CrazyGadgetMods/N64-RCP-Flex-Suite/RCP-FFC Cart Side Board/505110-4091/505110-4091.step

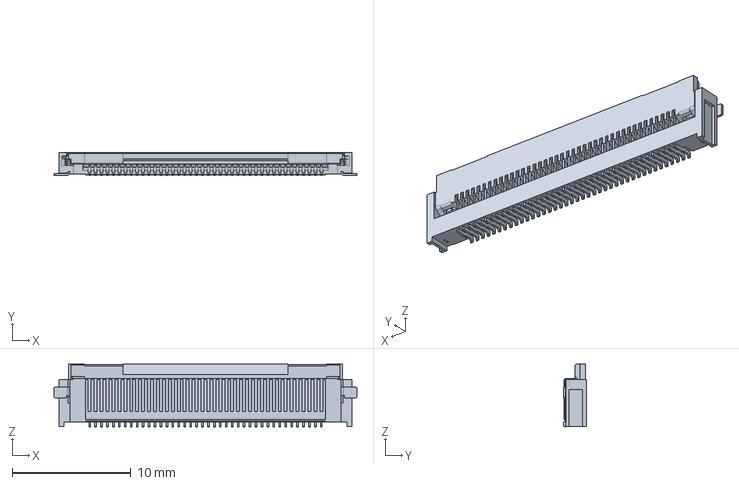
[picture p16: CAD file, 2024-05-08]
RCP-FFC Cart Side Board/505110-4091/505110-4091.step
25.5 x 1.90 x 5.30 mm
