CrazyGadgetMods/N64-RCP-Flex-Suite/RCP Breakout Flex/RCP-FLEX.kicad_sch

## KiCad design RCP Breakout Flex/RCP-FLEX.kicad_sch (2024-05-08)

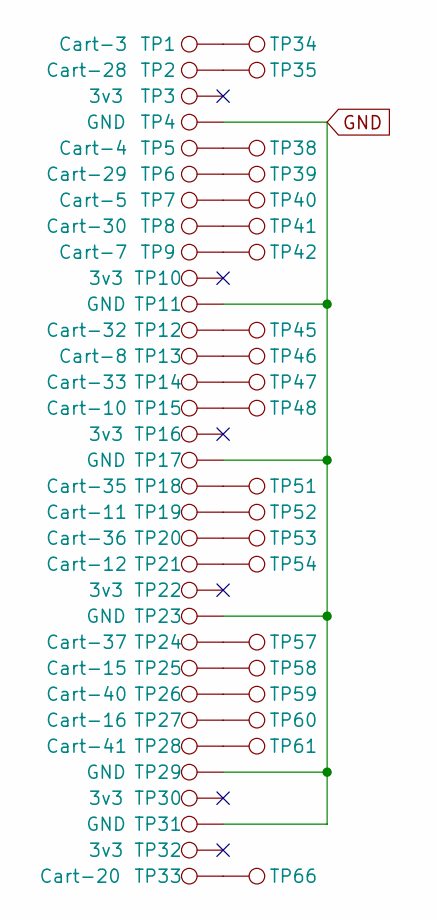
[picture p17: schematic RCP-FLEX.kicad_sch]

Parts:
TP1: Cart-3; TestPoint_RCP-NUS
TP2: Cart-28; TestPoint_RCP-NUS
TP3, TP10, TP16, TP22, TP30, TP32: 3v3; TestPoint_RCP-NUS
TP4, TP11, TP17, TP23, TP29, TP31: GND; TestPoint_RCP-NUS
TP5: Cart-4; TestPoint_RCP-NUS
TP6: Cart-29; TestPoint_RCP-NUS
TP7: Cart-5; TestPoint_RCP-NUS
TP8: Cart-30; TestPoint_RCP-NUS
TP9: Cart-7; TestPoint_RCP-NUS
TP12: Cart-32; TestPoint_RCP-NUS
TP13: Cart-8; TestPoint_RCP-NUS
TP14: Cart-33; TestPoint_RCP-NUS
TP15: Cart-10; TestPoint_RCP-NUS
TP18: Cart-35; TestPoint_RCP-NUS
TP19: Cart-11; TestPoint_RCP-NUS
TP20: Cart-36; TestPoint_RCP-NUS
TP21: Cart-12; TestPoint_RCP-NUS
TP24: Cart-37; TestPoint_RCP-NUS
TP25: Cart-15; TestPoint_RCP-NUS
TP26: Cart-40; TestPoint_RCP-NUS
TP27: Cart-16; TestPoint_RCP-NUS
TP28: Cart-41; TestPoint_RCP-NUS
TP33: Cart-20; TestPoint_RCP-NUS
TP34, TP35, TP38, TP39, TP40, TP41, TP42, TP45, TP46, TP47, TP48, TP51, TP52, TP53, TP54, TP57, TP58, TP59, TP60, TP61, TP66: TestPoint; TestPoint_Pad_D1.0mm

Connections:
GND: TP4.1, TP11.1, TP17.1, TP23.1, TP29.1, TP31.1
unnamed: TP1.1, TP34.1
unnamed: TP2.1, TP35.1
unnamed: TP12.1, TP45.1
unnamed: TP13.1, TP46.1
unnamed: TP14.1, TP47.1
unnamed: TP15.1, TP48.1
unnamed: TP18.1, TP51.1
unnamed: TP19.1, TP52.1
unnamed: TP20.1, TP53.1
unnamed: TP21.1, TP54.1
unnamed: TP24.1, TP57.1
unnamed: TP25.1, TP58.1
unnamed: TP26.1, TP59.1
unnamed: TP27.1, TP60.1
unnamed: TP28.1, TP61.1
unnamed: TP33.1, TP66.1
unnamed: TP5.1, TP38.1
unnamed: TP6.1, TP39.1
unnamed: TP7.1, TP40.1
unnamed: TP8.1, TP41.1
unnamed: TP9.1, TP42.1
