CrazyGadgetMods/N64-RCP-Flex-Suite/RCP-FFC Cart Side Board/N64 Cart FFC.kicad_sch

## KiCad design RCP-FFC Cart Side Board/N64 Cart FFC.kicad_sch (2024-05-08)

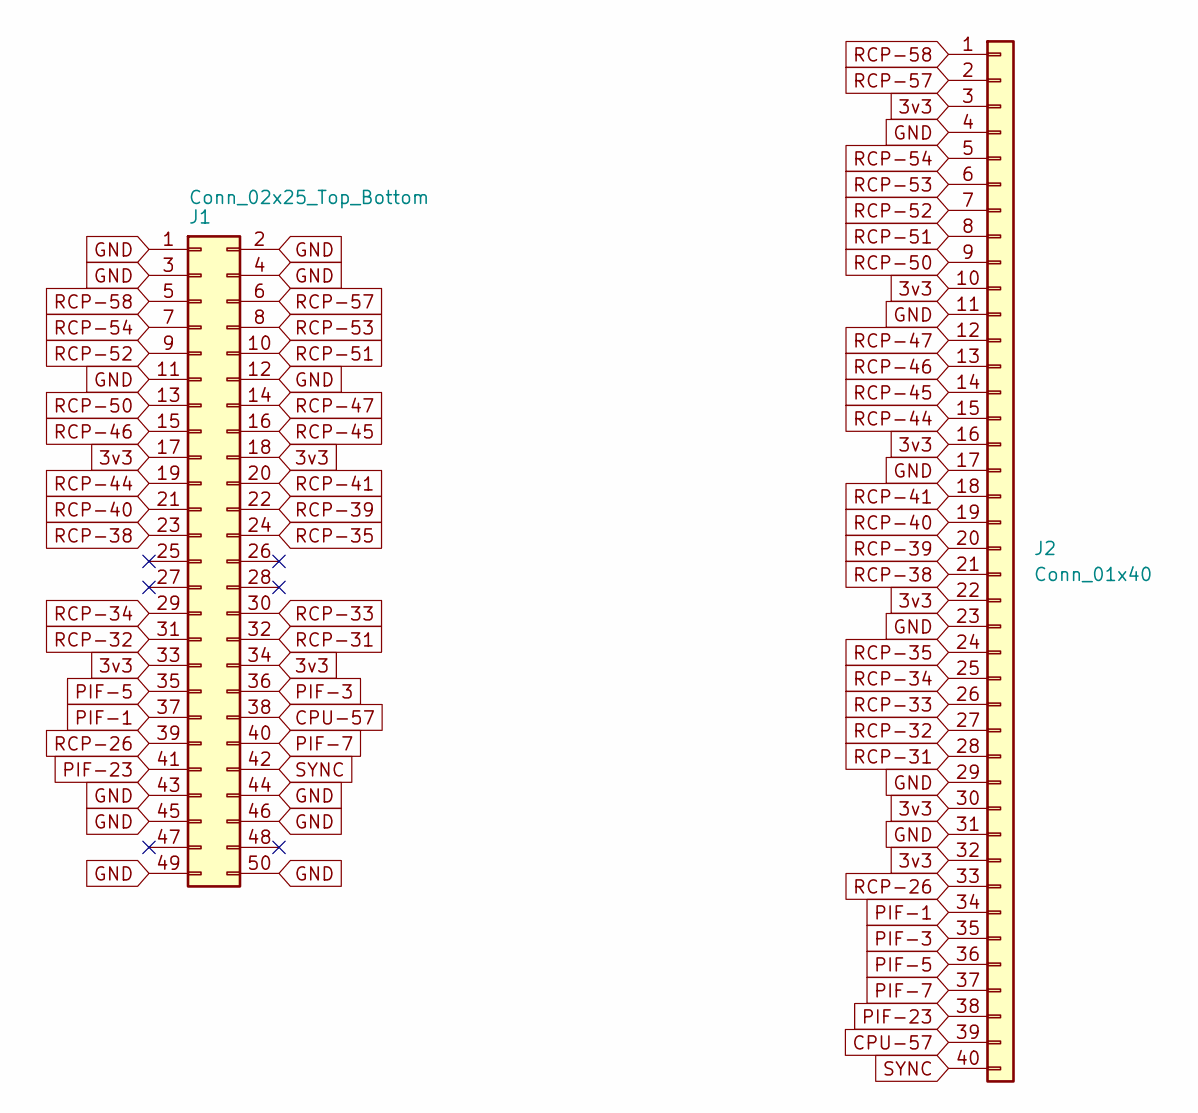
[picture p18: schematic N64 Cart FFC.kicad_sch]

Parts:
J1: Conn_02x25_Top_Bottom; IDC-Header_2x25_P2.54mm_Vertical
J2: Conn_01x40; MOLEX_505110-4091

Connections:
3v3: J1.17, J1.18, J1.33, J1.34, J2.3, J2.10, J2.16, J2.22, J2.30, J2.32
CPU-57: J1.38, J2.39
GND: J1.1, J1.2, J1.3, J1.4, J1.11, J1.12, J1.43, J1.44, J1.45, J1.46, J1.49, J1.50, J2.4, J2.11, J2.17, J2.23, J2.29, J2.31
PIF-1: J1.37, J2.34
PIF-3: J1.36, J2.35
PIF-5: J1.35, J2.36
PIF-7: J1.40, J2.37
PIF-23: J1.41, J2.38
RCP-26: J1.39, J2.33
RCP-31: J1.32, J2.28
RCP-32: J1.31, J2.27
RCP-33: J1.30, J2.26
RCP-34: J1.29, J2.25
RCP-35: J1.24, J2.24
RCP-38: J1.23, J2.21
RCP-39: J1.22, J2.20
RCP-40: J1.21, J2.19
RCP-41: J1.20, J2.18
RCP-44: J1.19, J2.15
RCP-45: J1.16, J2.14
RCP-46: J1.15, J2.13
RCP-47: J1.14, J2.12
RCP-50: J1.13, J2.9
RCP-51: J1.10, J2.8
RCP-52: J1.9, J2.7
RCP-53: J1.8, J2.6
RCP-54: J1.7, J2.5
RCP-57: J1.6, J2.2
RCP-58: J1.5, J2.1
SYNC: J1.42, J2.40
