CrazyGadgetMods/N64-RCP-Flex-Suite/RCP-FFC Flex/RCP-FLEX.kicad_sch

## KiCad design RCP-FFC Flex/RCP-FLEX.kicad_sch (2024-05-08)

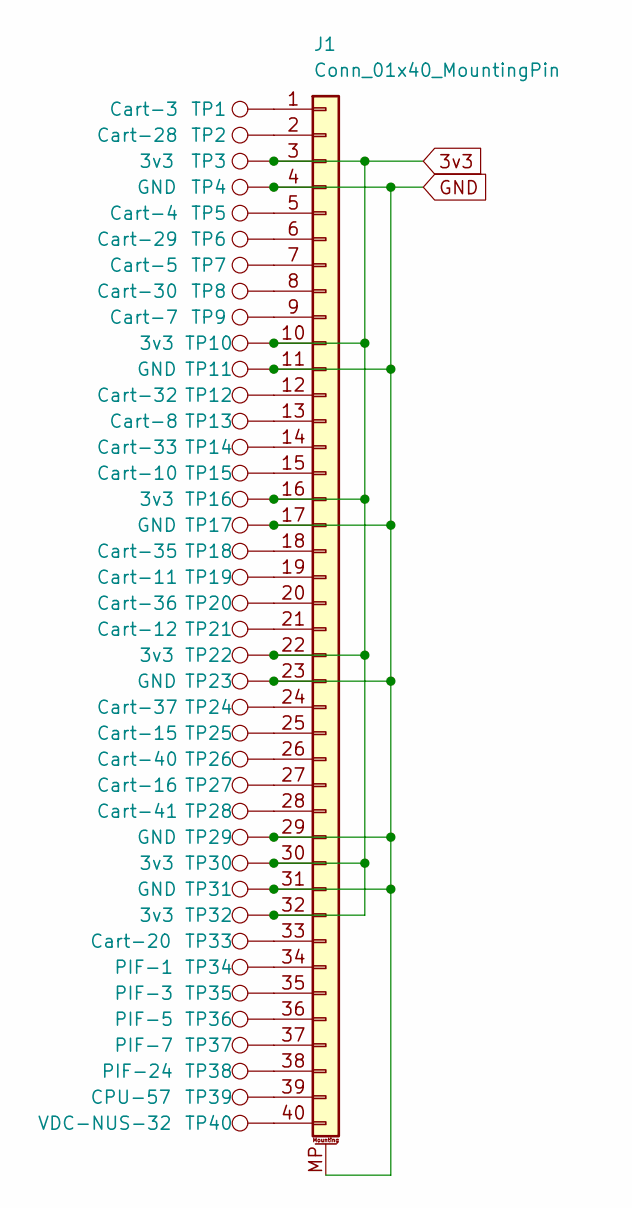
[picture p19: schematic RCP-FLEX.kicad_sch]

Parts:
J1: Conn_01x40_MountingPin; MOLEX_505110-4091-REVERSE-PINOUT
TP1: Cart-3; TestPoint_RCP-NUS
TP2: Cart-28; TestPoint_RCP-NUS
TP3, TP10, TP16, TP22, TP30, TP32: 3v3; TestPoint_RCP-NUS
TP4, TP11, TP17, TP23, TP29, TP31: GND; TestPoint_RCP-NUS
TP5: Cart-4; TestPoint_RCP-NUS
TP6: Cart-29; TestPoint_RCP-NUS
TP7: Cart-5; TestPoint_RCP-NUS
TP8: Cart-30; TestPoint_RCP-NUS
TP9: Cart-7; TestPoint_RCP-NUS
TP12: Cart-32; TestPoint_RCP-NUS
TP13: Cart-8; TestPoint_RCP-NUS
TP14: Cart-33; TestPoint_RCP-NUS
TP15: Cart-10; TestPoint_RCP-NUS
TP18: Cart-35; TestPoint_RCP-NUS
TP19: Cart-11; TestPoint_RCP-NUS
TP20: Cart-36; TestPoint_RCP-NUS
TP21: Cart-12; TestPoint_RCP-NUS
TP24: Cart-37; TestPoint_RCP-NUS
TP25: Cart-15; TestPoint_RCP-NUS
TP26: Cart-40; TestPoint_RCP-NUS
TP27: Cart-16; TestPoint_RCP-NUS
TP28: Cart-41; TestPoint_RCP-NUS
TP33: Cart-20; TestPoint_RCP-NUS
TP34: PIF-1; TestPoint_Pad_D1.0mm
TP35: PIF-3; TestPoint_Pad_D1.0mm
TP36: PIF-5; TestPoint_Pad_D1.0mm
TP37: PIF-7; TestPoint_Pad_D1.0mm
TP38: PIF-24; TestPoint_Pad_D1.0mm
TP39: CPU-57; TestPoint_Pad_D1.0mm
TP40: VDC-NUS-32; TestPoint_Pad_D1.0mm

Connections:
3v3: J1.3, J1.10, J1.16, J1.22, J1.30, J1.32, TP3.1, TP10.1, TP16.1, TP22.1, TP30.1, TP32.1
GND: J1.4, J1.11, J1.17, J1.23, J1.29, J1.31, J1.MP (MountPin), TP4.1, TP11.1, TP17.1, TP23.1, TP29.1, TP31.1
unnamed: J1.1, TP1.1
unnamed: J1.2, TP2.1
unnamed: J1.5, TP5.1
unnamed: J1.6, TP6.1
unnamed: J1.7, TP7.1
unnamed: J1.8, TP8.1
unnamed: J1.9, TP9.1
unnamed: J1.12, TP12.1
unnamed: J1.13, TP13.1
unnamed: J1.14, TP14.1
unnamed: J1.15, TP15.1
unnamed: J1.18, TP18.1
unnamed: J1.19, TP19.1
unnamed: J1.20, TP20.1
unnamed: J1.21, TP21.1
unnamed: J1.24, TP24.1
unnamed: J1.25, TP25.1
unnamed: J1.26, TP26.1
unnamed: J1.27, TP27.1
unnamed: J1.28, TP28.1
unnamed: J1.33, TP33.1
unnamed: J1.34, TP34.1
unnamed: J1.35, TP35.1
unnamed: J1.36, TP36.1
unnamed: J1.37, TP37.1
unnamed: J1.38, TP38.1
unnamed: J1.39, TP39.1
unnamed: J1.40, TP40.1
